ThaiToan-Vo/Electricity_Meter/Output/Hình ảnh 3D và kết quả.pdf

Hình ảnh 3D:

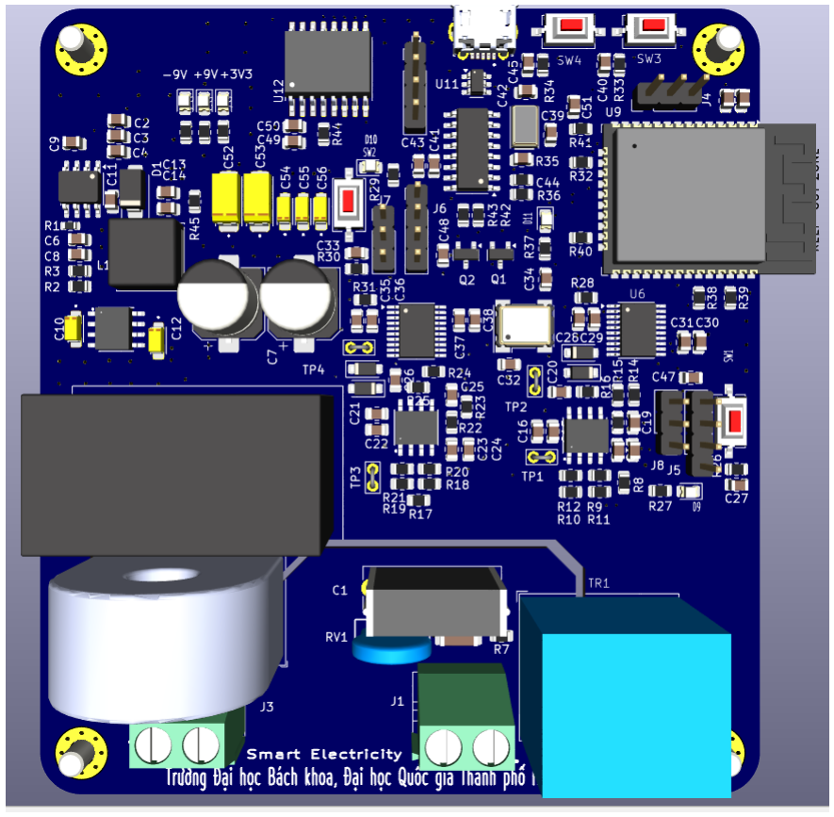
[picture p1: figure]

Hình ảnh board thực tế

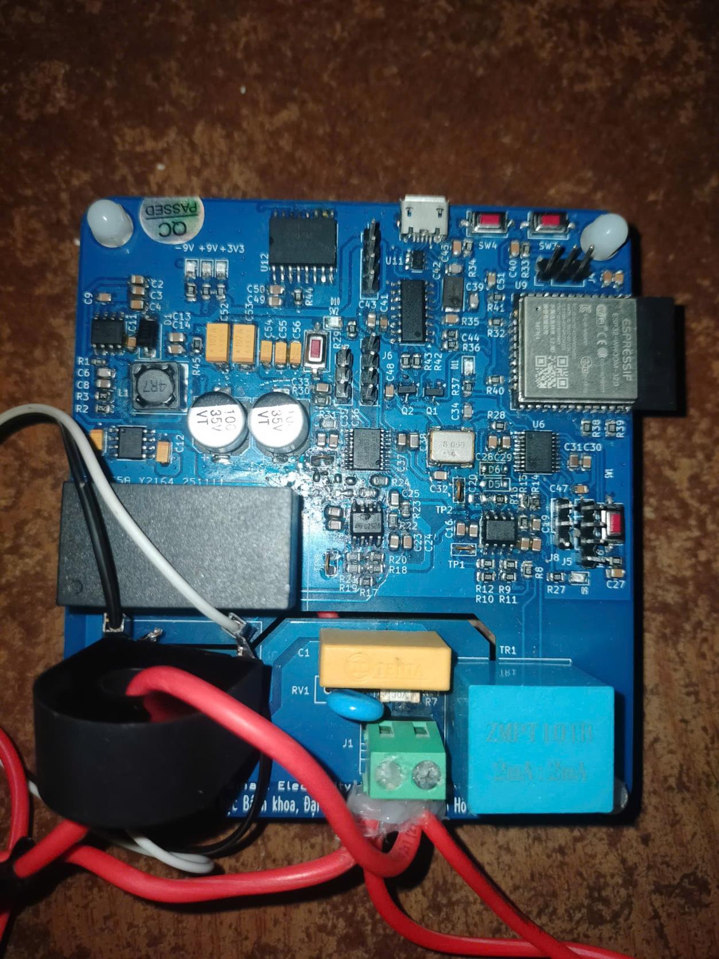
[picture p2: figure]

Output khi đo ấm đun siêu tốc

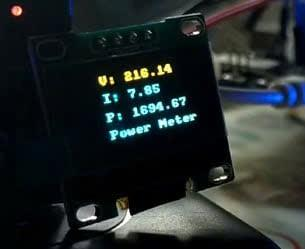
[picture p3: figure]
