ThaiToan-Vo/Electricity_Meter/Output/Bottom_layer.pdf

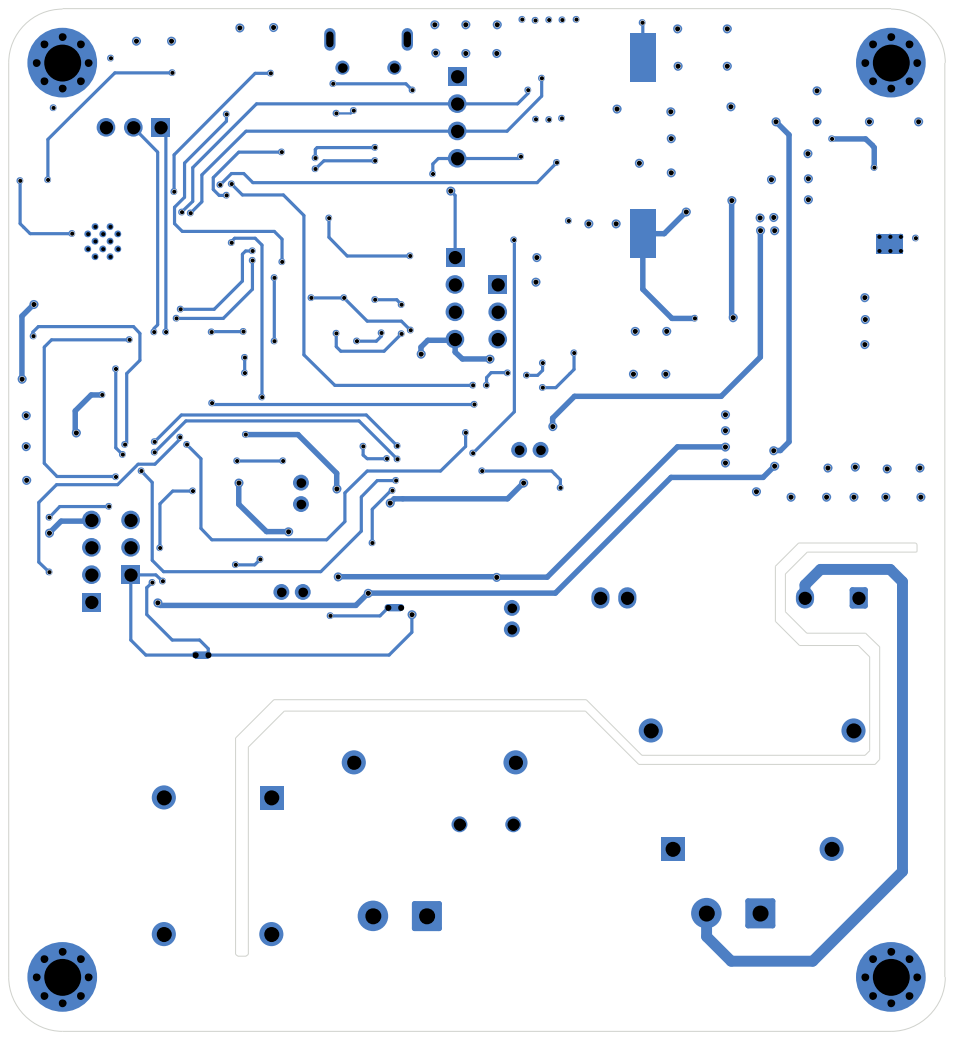
[picture p12: page 1]
