ThaiToan-Vo/Electricity_Meter/Output/Bottom_zone.pdf

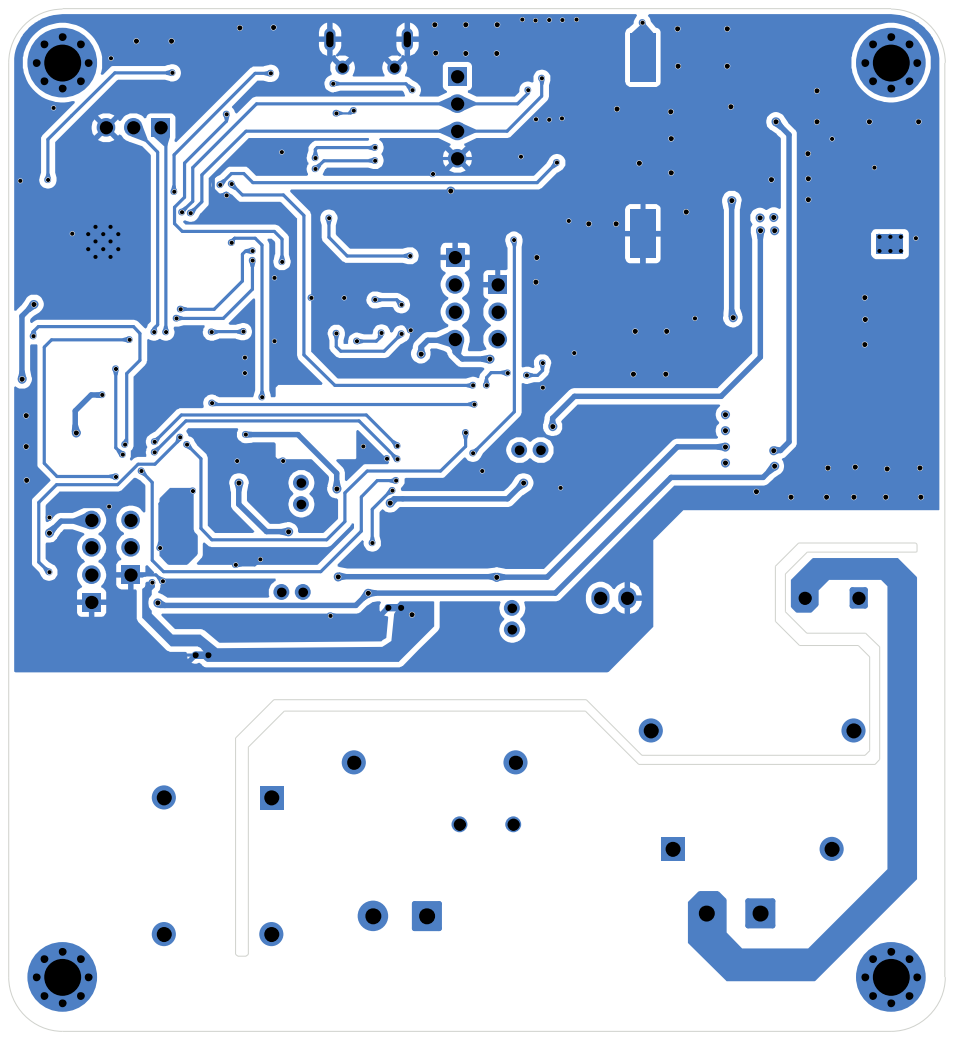
[picture p13: page 1]
