ThaiToan-Vo/Electricity_Meter/Output/Top_layer.pdf

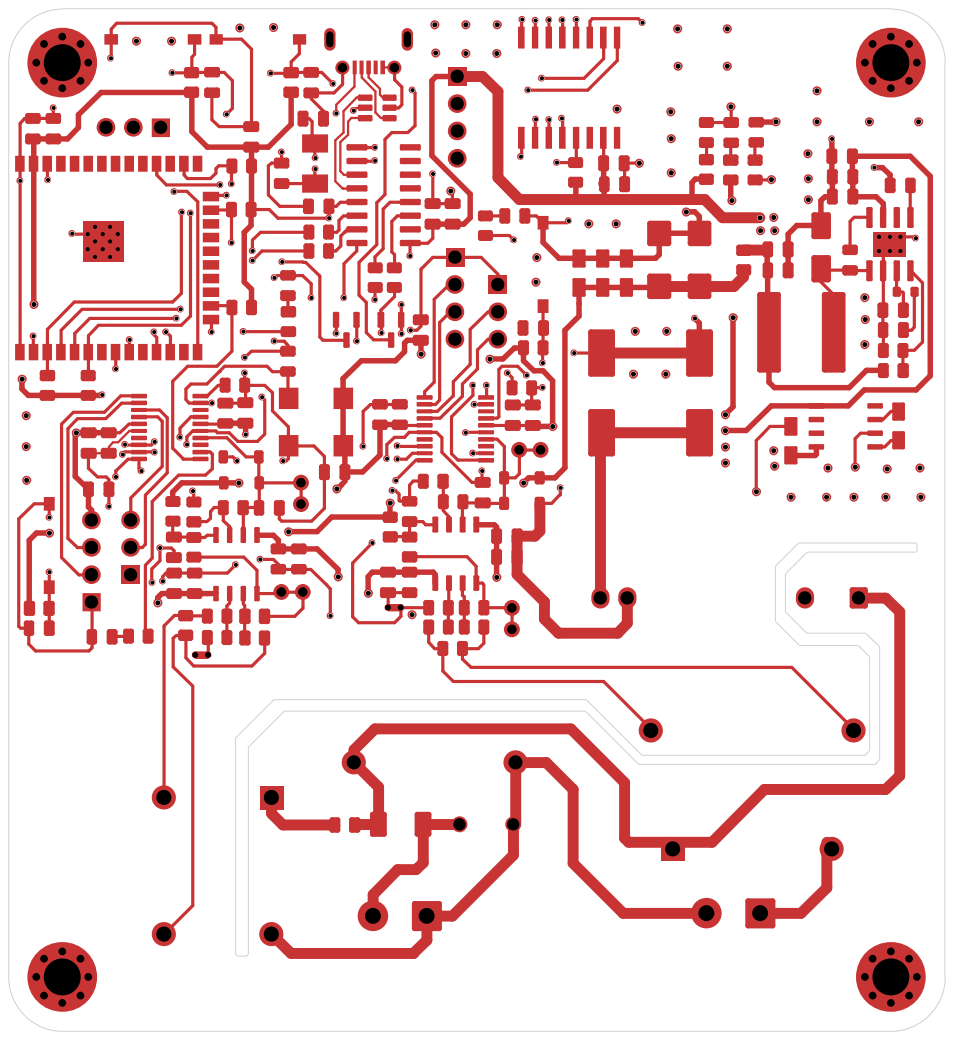
[picture p14: page 1]
