ThaiToan-Vo/Electricity_Meter/Output/Top_zone.pdf

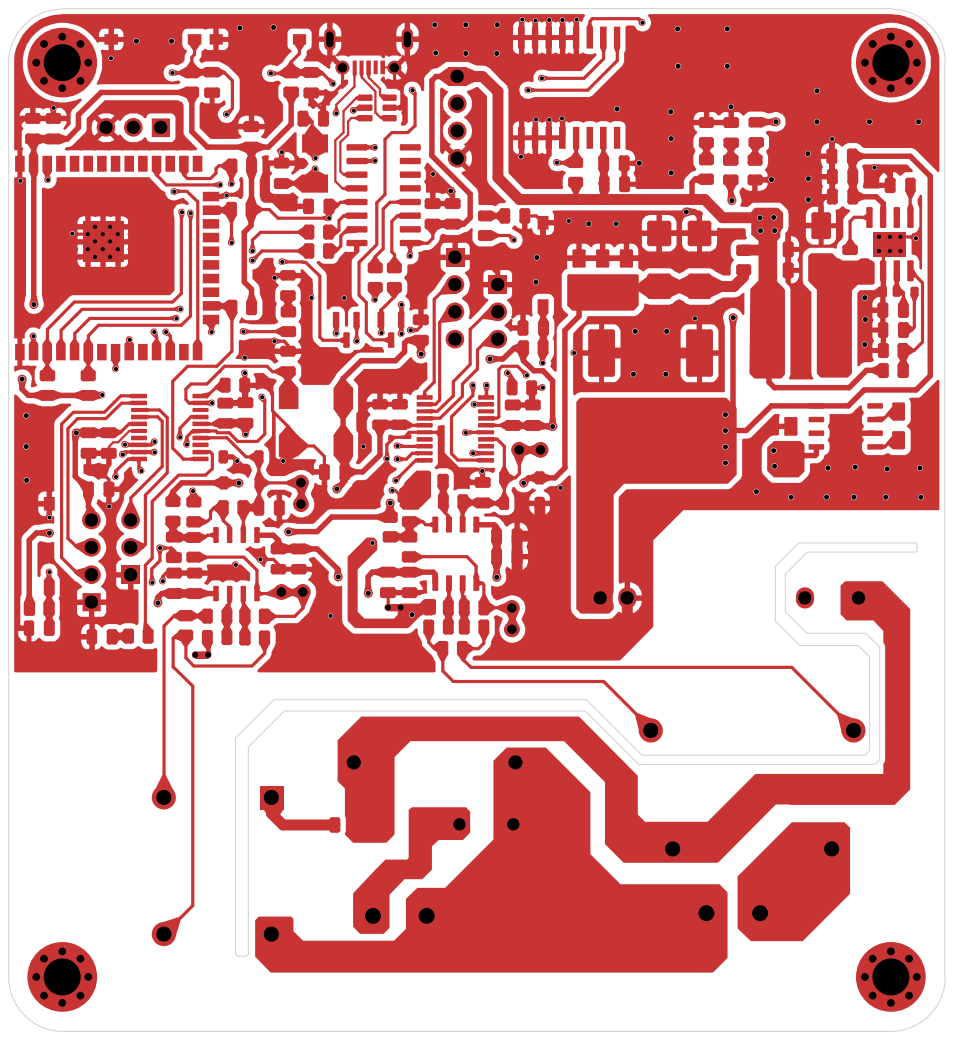
[picture p15: page 1]
