ThaiToan-Vo/Electricity_Meter/Firmware/STM32/Core/Src/main.c

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
/* Includes ------------------------------------------------------------------*/
#include "main.h"

/* USER CODE BEGIN Includes */
#include <stdio.h>
#include <string.h>
#include <stdbool.h>

/* USER CODE END Includes */

/* USER CODE BEGIN PTD */
#define RING_SIZE        640
#define FRAME_SAMPLES   50
#define FRAME_BYTES     (1 + FRAME_SAMPLES * 2)
uint16_t adc_dma_buf[10];
/* ring buffer ADC */
volatile uint16_t ring[RING_SIZE];
volatile uint16_t head = 0;
volatile uint16_t tail = 0;
volatile uint16_t ring_count = 0;


/* SPI buffers (8-bit) */

uint8_t rx[FRAME_BYTES];
uint8_t tx[FRAME_BYTES];

volatile uint32_t ring_overwrite = 0;

uint16_t s;			// variable for data
volatile uint8_t flag = 1;	// variable for preload tx SPI first
uint8_t itr =0;
uint8_t yes=0;
uint8_t no=0;
/* USER CODE END PTD */

ADC_HandleTypeDef hadc;
DMA_HandleTypeDef hdma_adc;

SPI_HandleTypeDef hspi1;
DMA_HandleTypeDef hdma_spi1_rx;
DMA_HandleTypeDef hdma_spi1_tx;

TIM_HandleTypeDef htim1;
TIM_HandleTypeDef htim3;

void SystemClock_Config(void);
static void MX_GPIO_Init(void);
static void MX_DMA_Init(void);
static void MX_ADC_Init(void);
static void MX_SPI1_Init(void);
static void MX_TIM1_Init(void);
static void MX_TIM3_Init(void);
/* USER CODE BEGIN 0 */

// ====== Init for Timer Trigger ADC ====== //
void HAL_GPIO_EXTI_Callback(uint16_t GPIO_Pin)
{
  /* Prevent unused argument(s) compilation warning */
  UNUSED(GPIO_Pin);
  if(GPIO_Pin == GPIO_PIN_0)
  {
  	  HAL_ADCEx_Calibration_Start(&hadc);
  	  HAL_ADC_Start_DMA(&hadc, (uint32_t*)adc_dma_buf, 1);
  	  HAL_TIM_Base_Start(&htim1);
  }
}

// ===== Ring buffer for data ===== //
static inline void ring_push(uint16_t sample)
{
    uint16_t next = head + 1;
    if (next >= RING_SIZE) next = 0;

    ring[head] = sample;
    head = next;

    if (ring_count < RING_SIZE)
    {
        ring_count++;
    }
    else
    {
        tail++;
        if (tail >= RING_SIZE)
        {
        	tail = 0;
        	ring_overwrite++;
        }
    }
}

static inline bool ring_pop(uint16_t *out)
{
    if (ring_count == 0) return false;
    *out = ring[tail];
    tail++;
    if (tail >= RING_SIZE) tail = 0;
    ring_count--;
    return true;
}


// ===== ADC callback every sample ===== //
void HAL_ADC_ConvCpltCallback(ADC_HandleTypeDef* hadc)
{
	ring_push(adc_dma_buf[0]);
	// preload first sample for SPI
	if (HAL_SPI_GetState(&hspi1) == HAL_SPI_STATE_READY) {
	    // Thực hiện nạp DMA
		ring_pop(&s);
		tx[0] = (uint8_t)(s & 0xFF);
		tx[1] = (uint8_t)(s >> 8);
		HAL_SPI_TransmitReceive_DMA(&hspi1, tx, rx, 2);

		HAL_GPIO_WritePin(GPIOA, GPIO_PIN_2, 0);
		HAL_TIM_Base_Start_IT(&htim3);
	}
//	if(flag == 1)
//	{
//		flag = 0 ;
//		ring_pop(&s);
//		tx[0] = (uint8_t)(s & 0xFF);
//		tx[1] = (uint8_t)(s >> 8);
//		HAL_SPI_TransmitReceive_DMA(&hspi1, tx, rx, 2);
//
//		HAL_GPIO_WritePin(GPIOA, GPIO_PIN_2, 0);
//		HAL_TIM_Base_Start_IT(&htim3);
//	}

	// interrupt for data ready
	itr++;



}

void HAL_TIM_PeriodElapsedCallback(TIM_HandleTypeDef *htim)
{
	HAL_GPIO_WritePin(GPIOA, GPIO_PIN_2, 1);
	HAL_TIM_Base_Stop_IT(&htim3);
}
// ===== SPI callback after transmitting ===== //
void HAL_SPI_TxRxCpltCallback(SPI_HandleTypeDef *hspi)
{

//	 if (ring_pop(&s))
//	 {
//		 tx[0] = (uint8_t)(s & 0xFF);
//		 tx[1] = (uint8_t)(s >> 8);
//		 yes++;
//	 }
//	 else
//	 {
//		 tx[0] = 0;
//		 tx[1] = 0;
//		 no++;
//	 }
//	 // preload for next transmit
//	 HAL_SPI_TransmitReceive_DMA(&hspi1, tx, rx, 2);
//
//	 HAL_GPIO_WritePin(GPIOA, GPIO_PIN_2, 0);
//	 HAL_TIM_Base_Start_IT(&htim3);

}



/* USER CODE END 0 */

/**
  * @brief  The application entry point.
  * @retval int
  */
int main(void)
{
  /* MCU Configuration--------------------------------------------------------*/

  /* Reset of all peripherals, Initializes the Flash interface and the Systick. */
  HAL_Init();

  /* Configure the system clock */
  SystemClock_Config();

  /* Initialize all configured peripherals */
  MX_GPIO_Init();
  MX_DMA_Init();
  MX_ADC_Init();
  MX_SPI1_Init();
  MX_TIM1_Init();
  MX_TIM3_Init();
  /* Infinite loop */
  /* USER CODE BEGIN WHILE */
  while (1)
  {


    /* USER CODE END WHILE */

    /* USER CODE BEGIN 3 */
  }
  /* USER CODE END 3 */
}

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
