ThaiToan-Vo/Electricity_Meter/Firmware/STM32/Vol_SPI.ioc

Mcu.UserName=STM32F030F4Px
PA0.Signal=GPXTI0
PA1.Signal=ADC_IN1
PA13.Signal=SYS_SWDIO
PA14.Signal=SYS_SWCLK
PA2.Signal=GPIO_Output
PA4.Signal=SPI1_NSS
PA5.Signal=SPI1_SCK
PA6.Signal=SPI1_MISO
PA7.Signal=SPI1_MOSI
PF0-OSC_IN.Signal=RCC_OSC_IN
