ThaiToan-Vo/Electricity_Meter/Firmware/ESP_IDF/main/task_read_data.h

#include "process.h"

#ifndef TASK_READ_DATA_H
#define TASK_READ_DATA_H

extern TaskHandle_t read_data_handle;




extern uint16_t v_buf_raw[FRAME_SAMPLES];
extern uint16_t i_buf_raw[FRAME_SAMPLES];

extern uint8_t  v_idx;
extern uint8_t  i_idx;

// Struct để gửi frame data qua queue
typedef struct {
    uint16_t v_buf[FRAME_SAMPLES];
    uint16_t i_buf[FRAME_SAMPLES];
} frame_data_t;

// Queue để gửi frame data
extern QueueHandle_t frame_queue;

void app_task_read_data_init();

#endif /* TASK_READ_DATA_H */
